ok1cdj/FT817-satmode/cable.jpg

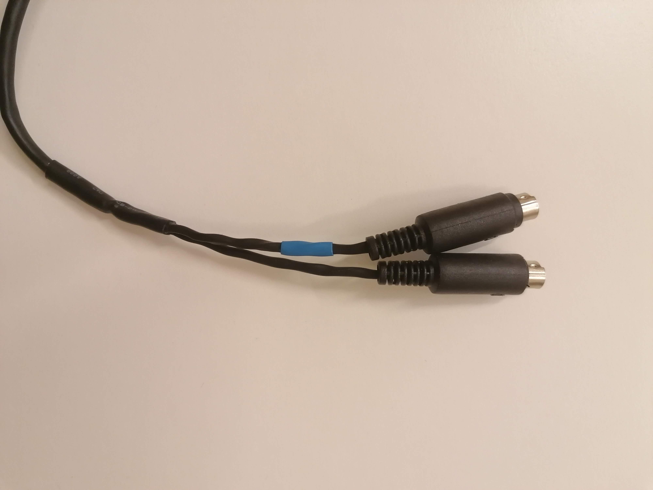
cable.jpg
