ok1cdj/FT817-satmode/FT817-ACC.png

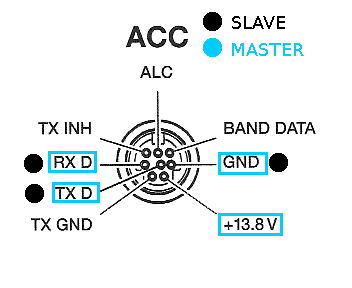
FT817-ACC.png
