ok1cdj/FT817-satmode/pcb.png

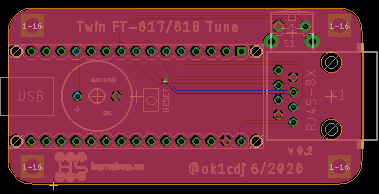
pcb.png
