ok1cdj/FT817-satmode/schematic.png

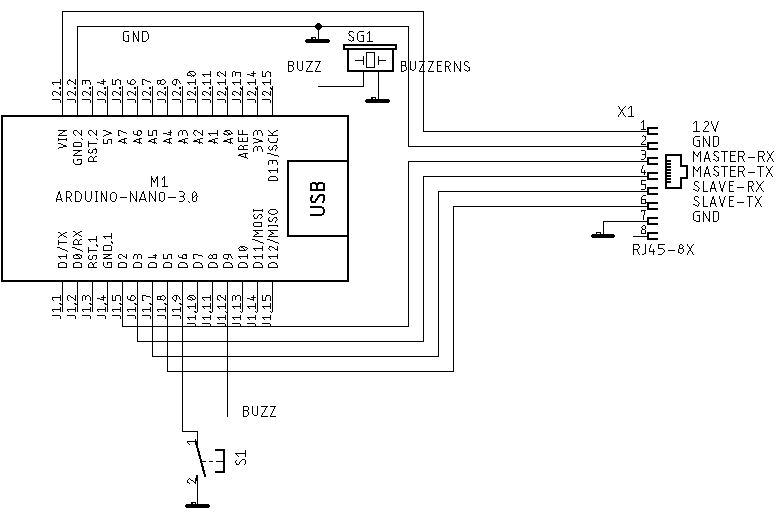
schematic.png
