ok1cdj/FT817-satmode/(threads)

Thread 1 (2020-08-15):

clarification on TX and RX

supercazzola, 2020-08-15:
Clarification should be made in the program regarding the use of TX and RX nomenclature. What is TX on Radio may be RX on device. I recommend stating which pin of the 8 pin mini DIN the connections should be made to.

For example:
D2 connects to position 4 of the ACC port for master radio
D3 connects to position 5 of the ACC port for master radio
D4 connects to position 4 of the ACC port for the slave radio
D5 connects to position 5 of the ACC port for the slave radio

ok1cdj, 2020-10-12:
Desc is in wiki now...

Closed 2020-10-12.

Thread 2 (2020-10-30):

Suggestion on pinouts

supercazzola, 2020-10-30:
I suggest you clarify the pin outs digram. Is it looking at the back of the connector (from the solder side) ?  It is best to explain so there is no doubt.

DM5TU, 2020-12-04:
The 8pin DIN connector is shown from the back (solder side), yes. This is how I see it, too.
Is your setup working?

I have issues and can not get the tracking mode to work.

DM5TU, 2020-12-04:
The kit is soldered  and the sketch is running.
The serial monitor is showing the following after Master (FT818 TX) and Slave (FT187 RX) is connected as proposed.

Init FT817 Master
Init FT817 Slave
FRQ slave:0
FRQ master:0

**Should the frequncy be readable here already?**

I checked the soldering twice and did not find any deviataions from the plan.

**The 8pin DIN connector is shown from the backside, right?**

On the RJ45 I checked the voltages on pin 1 to pin 2 and 7 (GND)  = 13.3 Volt - That is OK

**So pin 1 on RJ45 is on the left side when looking from the top, right?**

Lets start from here and see what we can find out.

TNX Ondrej es 73 de DM5TU

ok1cdj, 2020-12-04:
Yes, you need See frequency here. Do you have set speed of both FT817 to 9600??

73 Ondra

DM5TU, 2020-12-04:
I use a FT818 and FT817.
Yes in Setup Mode No. 14 CAT RATE is 9600 on both

supercazzola, 2020-12-04:
You must have baud rates set correctly or else even pushing the button will
seem like it is not working.
It happened to me.
--Kevin (KK4YEL)

On Fri, Dec 4, 2020 at 1:13 PM DM5TU - sTef <notifications@github.com>
wrote:

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

--
"Es mejor morir de pie que vivir de rodillas" - Emiliano Zapata

DM5TU, 2020-12-04:
I think I did something wrong with the RJ45 to the DIN connectors.

On the RJ45 I checked the voltages on pin 1 to pin 2 and 7 (GND) = 13.3 Volt - That is OK

**So pin 1 on RJ45 is on the left side when looking from the top, right?**

DM5TU, 2020-12-19:
Got new 8ppn mini DIN connectors. System is working fine now. @ok1cdj the quality of the delivered 8pin connectors was not that nice. The sooldering pins are made for a one time shoot. Anyway great kit. Tnx fer your effort, @ok1cdj   72/3 de sTef DM5TU

DM5TU, 2020-12-19:
@ok1cdj One issue just turned out. If I change the Master (TX 818) & Slave (RX 817) the controller does not work. The 818 needs to be my MASTER. The voltage output of the 817 on the ACC port is 12.9V about 0.4 V lower than on the 817. Is the 12.9V too low for the kit @ok1cdj ?

ok1cdj, 2020-12-21:
@DM5TU i have not FT-818 in my hand. I have two FT-817. There is 5V LDO in Arduino. All with more than 7V is OK. There is 10R resitor in FT-817 as fuse in schematic of FT-817 in ACC connector. I don't know why it not works with both for you.

DM5TU, 2020-12-21:
@ok1cdj TNT fer ur reply. Yes until now I do not know either. May I will compare the schematic from the 817 with the 818. Maybe we see a difference, but the over 12V output should ne enough for the Arduino. Great kit but please supply better 8 Pin Mini DIN plugs in the future. I now used the ones from REICHELT.DE at 0.88€ per pcs. Part-No.: SE-DIO M08 they worked well. 73 de sTef DM5TU
