ok1cdj/FT817-satmode/(commit log)

2020-10-12 ACC connector of FT-8X7
2020-10-12 Schematic and PCB
2020-10-12 Picture of cable
